gerdb/timbremin/pics/chorus_algorithm.png

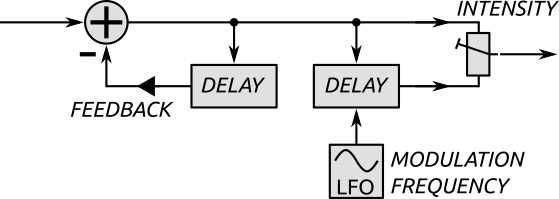
pics/chorus_algorithm.png
