gerdb/timbremin/pics/oscillators.jpg

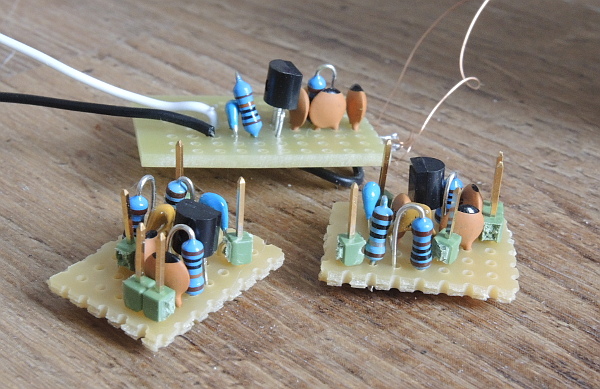
pics/oscillators.jpg
