gerdb/timbremin/pics/power_supply_photo1.jpg

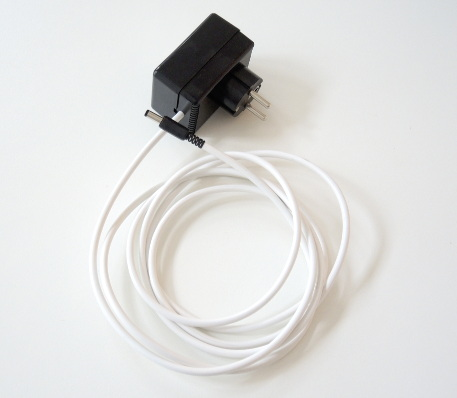
pics/power_supply_photo1.jpg
