gerdb/timbremin/pics/power_supply_photo2.jpg

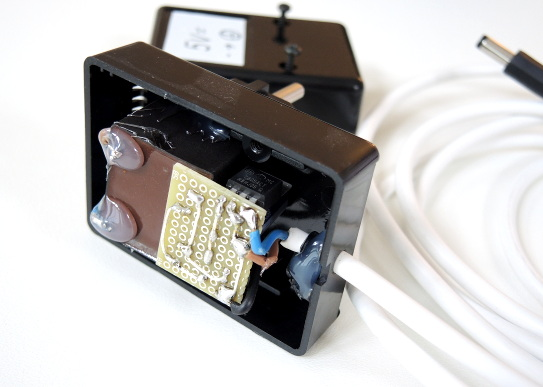
pics/power_supply_photo2.jpg
