gerdb/timbremin/pics/timbremin_osc_pcb_thd.png

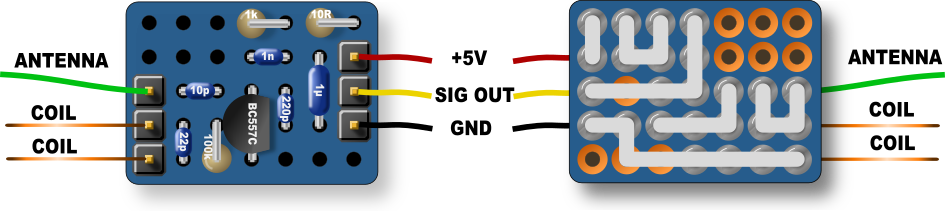
pics/timbremin_osc_pcb_thd.png
