gerdb/timbremin/Software/Src/main.c

/**
  ******************************************************************************
  * @file           : main.c
  * @brief          : Main program body
  ******************************************************************************
  * This notice applies to any and all portions of this file
  * that are not between comment pairs USER CODE BEGIN and
  * USER CODE END. Other portions of this file, whether 
  * inserted by the user or by software development tools
  * are owned by their respective copyright owners.
  *
  * Copyright (c) 2019 STMicroelectronics International N.V. 
  * All rights reserved.
  *
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
  ******************************************************************************
  */
/* Includes ------------------------------------------------------------------*/
#include "main.h"
#include "stm32f4xx_hal.h"
#include "fatfs.h"
#include "usb_host.h"

/* USER CODE BEGIN Includes */
#include "../Drivers/BSP/STM32F4-Discovery/stm32f4_discovery.h"
#include "audio_out.h"
#include "theremin.h"
#include "pots.h"
#include "config.h"
#include "beep.h"
#include "volume.h"
#include "pitch.h"
#include "effect.h"
#include "printf.h"
#include "console.h"
/* USER CODE END Includes */

ADC_HandleTypeDef hadc1;
DMA_HandleTypeDef hdma_adc1;

I2C_HandleTypeDef hi2c1;

I2S_HandleTypeDef hi2s3;

RNG_HandleTypeDef hrng;

SPI_HandleTypeDef hspi1;

TIM_HandleTypeDef htim1;

UART_HandleTypeDef huart3;

/* USER CODE BEGIN PV */


/* USER CODE END PV */

void SystemClock_Config(void);
static void MX_GPIO_Init(void);
static void MX_DMA_Init(void);
static void MX_I2C1_Init(void);
static void MX_I2S3_Init(void);
static void MX_SPI1_Init(void);
static void MX_TIM1_Init(void);
static void MX_ADC1_Init(void);
static void MX_RNG_Init(void);
static void MX_USART3_UART_Init(void);
void MX_USB_HOST_Process(void);

/* USER CODE BEGIN PFP */

/* USER CODE END PFP */

/* USER CODE BEGIN 0 */
//extern void initialise_monitor_handles(void);
int siFlag1ms = 0;

/* USER CODE END 0 */

/**
  * @brief  The application entry point.
  *
  * @retval None
  */
int main(void)
{
  /* MCU Configuration----------------------------------------------------------*/

  /* Reset of all peripherals, Initializes the Flash interface and the Systick. */
  HAL_Init();

  /* Configure the system clock */
  SystemClock_Config();

  /* Initialize all configured peripherals */
  MX_GPIO_Init();
  MX_DMA_Init();
  MX_I2C1_Init();
  MX_I2S3_Init();
  MX_SPI1_Init();
  MX_USB_HOST_Init();
  MX_TIM1_Init();
  MX_ADC1_Init();
  MX_FATFS_Init();
  MX_RNG_Init();
  MX_USART3_UART_Init();
  /* USER CODE BEGIN 2 */
  CONFIG_Init();
  POTS_Init();
  BEEP_Init();
  VOLUME_Init();
  THEREMIN_Init();
  AUDIO_OUT_Init();
  EFFECT_Init();
  CONSOLE_Init(huart3);

  HAL_TIM_Base_Start(&htim1);
  HAL_TIM_IC_Start(&htim1,TIM_CHANNEL_1);
  HAL_TIM_IC_Start(&htim1,TIM_CHANNEL_2);
  HAL_TIM_IC_Start(&htim1,TIM_CHANNEL_3);

  BSP_PB_Init(BUTTON_KEY, BUTTON_MODE_GPIO);
  /* USER CODE END 2 */

  /* Infinite loop */
  /* USER CODE BEGIN WHILE */
  while (1)
  {
  /* USER CODE END WHILE */
    MX_USB_HOST_Process();

  /* USER CODE BEGIN 3 */
	if (siFlag1ms)
	{
		siFlag1ms = 0;
	    THEREMIN_1msTask();
	    VOLUME_1msTask();
	    PITCH_1msTask();
	    POTS_1msTask();
	    AUDIO_OUT_1msTask();
	    CONSOLE_1msTask();
	    EFFECT_1msTask();
	}
  }
  /* USER CODE END 3 */

}

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
