gerdb/timbremin/Software/Inc/beepwave.h

/**
 *  Project     timbremin
 *  @file		notes.h
 *  @author		Gerd Bartelt - www.sebulli.com
 *  @brief		Wave table with beep sound
 *
 *  @copyright	GPL3
 *
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
 */

#ifndef BEEPWAVE_H_
#define BEEPWAVE_H_

const int16_t usBeepWave[1024] = {0	,
		201	,
		402	,
		603	,
		804	,
		1005	,
		1206	,
		1407	,
		1608	,
		1809	,
		2009	,
		2210	,
		2410	,
		2611	,
		2811	,
		3012	,
		3212	,
		3412	,
		3612	,
		3811	,
		4011	,
		4210	,
		4410	,
		4609	,
		4808	,
		5007	,
		5205	,
		5404	,
		5602	,
		5800	,
		5998	,
		6195	,
		6393	,
		6590	,
		6786	,
		6983	,
		7179	,
		7375	,
		7571	,
		7767	,
		7962	,
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

};

#endif /* BEEPWAVE_H_ */
