gerdb/timbremin/Software/Src/printf.c

/*
 *  Project:      timbremin
 *  File:         printf.c
 *  Author:       Gerd Bartelt - www.sebulli.com
 *
 *  Description:  This a an modified version of printf
 *  			  Original file is written by Georges Menie.
 *
 */

/*
	Copyright 2001, 2002 Georges Menie (www.menie.org)

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
    You should have received a copy of the GNU Lesser General Public License
    along with this program; if not, write to the Free Software
    Foundation, Inc., 59 Temple Place, Suite 330, Boston, MA  02111-1307  USA
*/

/*
	putchar is the only external dependency for this file,
	if you have a working putchar, just remove the following
	define. If the function should be called something else,
	replace outbyte(c) by your own function call.
*/

/* Includes ------------------------------------------------------------------*/
#include "printf.h"

/**
 * The printchar function that uses the USART
 */
static void printchar(int c)
{
	CONSOLE_PutByte(& UartHandle, c);
}

#define PAD_RIGHT 1
#define PAD_ZERO 2

static int prints(const char *string, int width, int pad)
{
	register int pc = 0, padchar = ' ';

	if (width > 0) {
		register int len = 0;
		register const char *ptr;
		for (ptr = string; *ptr; ++ptr) ++len;
		if (len >= width) width = 0;
		else width -= len;
		if (pad & PAD_ZERO) padchar = '0';
	}
	if (!(pad & PAD_RIGHT)) {
		for ( ; width > 0; --width) {
			printchar (padchar);
			++pc;
		}
	}
	for ( ; *string ; ++string) {
		printchar (*string);
		++pc;
	}
	for ( ; width > 0; --width) {
		printchar (padchar);
		++pc;
	}

	return pc;
}

/* the following should be enough for 32 bit int */
#define PRINT_BUF_LEN 12

static int printi(int i, int b, int sg, int width, int pad, int letbase)
{
	char print_buf[PRINT_BUF_LEN];
	register char *s;
	register int t, neg = 0, pc = 0;
	register unsigned int u = i;

	if (i == 0) {
		print_buf[0] = '0';
		print_buf[1] = '\0';
		return prints (print_buf, width, pad);
	}

	if (sg && b == 10 && i < 0) {
		neg = 1;
		u = -i;
	}

	s = print_buf + PRINT_BUF_LEN-1;
	*s = '\0';

	while (u) {
		t = u % b;
		if( t >= 10 )
			t += letbase - '0' - 10;
		*--s = t + '0';
		u /= b;
	}

	if (neg) {
		if( width && (pad & PAD_ZERO) ) {
			printchar ('-');
			++pc;
			--width;
		}
		else {
			*--s = '-';
		}
	}

	return pc + prints (s, width, pad);
}

static int print(int *varg)
{
	register int width, pad;
	register int pc = 0;
	register char *format = (char *)(*varg++);
	char scr[2];

	for (; *format != 0; ++format) {
		if (*format == '%') {
			++format;
			width = pad = 0;
			if (*format == '\0') break;
			if (*format == '%') goto out;
			if (*format == '-') {
				++format;
				pad = PAD_RIGHT;
			}
			while (*format == '0') {
				++format;
				pad |= PAD_ZERO;
			}
			for ( ; *format >= '0' && *format <= '9'; ++format) {
				width *= 10;
				width += *format - '0';
			}
			if( *format == 's' ) {
				register char *s = *((char **)varg++);
				pc += prints ( s?s:"(null)", width, pad);
				continue;
			}
			if( *format == 'd' ) {
				pc += printi ( *varg++, 10, 1, width, pad, 'a');
				continue;
			}
			if( *format == 'x' ) {
				pc += printi ( *varg++, 16, 0, width, pad, 'a');
				continue;
			}
			if( *format == 'X' ) {
				pc += printi ( *varg++, 16, 0, width, pad, 'A');
				continue;
			}
			if( *format == 'u' ) {
				pc += printi ( *varg++, 10, 0, width, pad, 'a');
				continue;
			}
			if( *format == 'c' ) {
				/* char are converted to int then pushed on the stack */
				scr[0] = *varg++;
				scr[1] = '\0';
				pc += prints (scr, width, pad);
				continue;
			}
		}
		else {
		out:
			printchar (*format);
			++pc;
		}
	}
	return pc;
}

/* assuming sizeof(void *) == sizeof(int) */

int my_printf(const char *format, ...)
{
	register int *varg = (int *)(&format);
	return print(varg);
}
