gerdb/timbremin/Software/Inc/notes.h

/**
 *  Project     timbremin
 *  @file		notes.h
 *  @author		Gerd Bartelt - www.sebulli.com
 *  @brief		Frequency of piano notes
 *
 *  @copyright	GPL3
 *
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
 */

#ifndef NOTES_H_
#define NOTES_H_

#define	NOTE_C8		4186.01f
#define	NOTE_B7		3951.07f
#define	NOTE_AIS7	3729.31f
#define	NOTE_A7		3520.00f
#define	NOTE_GIS7	3322.44f
#define	NOTE_G7		3135.96f
#define	NOTE_FIS7	2959.96f
#define	NOTE_F7		2793.83f
#define	NOTE_E7		2637.02f
#define	NOTE_DIS7	2489.02f
#define	NOTE_D7		2349.32f
#define	NOTE_CIS7	2217.46f
#define	NOTE_C7		2093.00f
#define	NOTE_B6		1975.53f
#define	NOTE_AIS6	1864.66f
#define	NOTE_A6		1760.00f
#define	NOTE_GIS6	1661.22f
#define	NOTE_G6		1567.98f
#define	NOTE_FIS6	1479.98f
#define	NOTE_F6		1396.91f
#define	NOTE_E6		1318.51f
#define	NOTE_DIS6	1244.51f
#define	NOTE_D6		1174.66f
#define	NOTE_CIS6	1108.73f
#define	NOTE_C6		1046.50f
#define	NOTE_B5		987.77f
#define	NOTE_AIS5	932.33f
#define	NOTE_A5		880.00f
#define	NOTE_GIS5	830.61f
#define	NOTE_G5		783.99f
#define	NOTE_FIS5	739.99f
#define	NOTE_F5		698.46f
#define	NOTE_E5		659.26f
#define	NOTE_DIS5	622.25f
#define	NOTE_D5		587.33f
#define	NOTE_CIS5	554.37f
#define	NOTE_C5		523.25f
#define	NOTE_B4		493.88f
#define	NOTE_AIS4	466.16f
#define	NOTE_A4		440.00f
#define	NOTE_GIS4	415.31f
#define	NOTE_G4		392.00f
#define	NOTE_FIS4	369.99f
#define	NOTE_F4		349.23f
#define	NOTE_E4		329.63f
#define	NOTE_DIS4	311.13f
#define	NOTE_D4		293.67f
#define	NOTE_CIS4	277.18f
#define	NOTE_C4		261.63f
#define	NOTE_B3		246.94f
#define	NOTE_AIS3	233.08f
#define	NOTE_A3		220.00f
#define	NOTE_GIS3	207.65f
#define	NOTE_G3		196.00f
#define	NOTE_FIS3	185.00f
#define	NOTE_F3		174.61f
#define	NOTE_E3		164.81f
#define	NOTE_DIS3	155.56f
#define	NOTE_D3		146.83f
#define	NOTE_CIS3	138.59f
#define	NOTE_C3		130.81f
#define	NOTE_B2		123.47f
#define	NOTE_AIS2	116.54f
#define	NOTE_A2		110.00f
#define	NOTE_GIS2	103.83f
#define	NOTE_G2		98.00f
#define	NOTE_FIS2	92.50f
#define	NOTE_F2		87.31f
#define	NOTE_E2		82.41f
#define	NOTE_DIS2	77.78f
#define	NOTE_D2		73.42f
#define	NOTE_CIS2	69.30f
#define	NOTE_C2		65.41f
#define	NOTE_B1		61.74f
#define	NOTE_AIS1	58.27f
#define	NOTE_A1		55.00f
#define	NOTE_GIS1	51.91f
#define	NOTE_G1		49.00f
#define	NOTE_FIS1	46.25f
#define	NOTE_F1		43.65f
#define	NOTE_E1		41.20f
#define	NOTE_DIS1	38.89f
#define	NOTE_D1		36.71f
#define	NOTE_CIS1	34.65f
#define	NOTE_C1		32.70f
#define	NOTE_B0		30.87f
#define	NOTE_AIS0	29.14f
#define	NOTE_A0		27.50f

#endif /* NOTES_H_ */
