gerdb/timbremin/(commit log)

2018-11-16 First import of software
    [timbremin Debug Semihosting.cfg, timbremin Debug.cfg, timbremin Semihosting.cfg]
2018-12-16 Write volume calibration result to USB stick. Beeps only on headphone output
2018-12-25 PITCH calibration
2018-12-26 Use of pitch table to scale and shift the pitch values
2018-12-28 Scaled frequency to Hz for pitch display Index of config file in round brackets
2018-12-28 Removed WAV table support. Added non-linearity of sin oscillator. Bugfix amplitude regulation of oscillator.
    [audio_out.c, audio_out.h, beep.c, theremin.c, theremin.h]
2018-12-29 Start with auto-tune after start-up not earlier than after the power-on beep. Reduced volume of beep.
2019-01-10 Updated Logo and added power supply pictures
2019-01-10 Updated PCB of oscillator
2019-01-11 Updated BOM
2019-01-26 Pitch filter is running during "beep" to ensure proper values during auto-tune. Output values clipped.
2019-02-03 Added 2 photos of the power suplly unit
2019-02-16 Debug output of HF-oscillator values Renames some function names
    [audio_out.c, config.c, console.c, console.h, effect.c, effect.h, main.c, theremin.c]
2019-02-16 Bugfix: Characters were lost during sending a string.
    [console.c]
2019-02-16 Extended Range of oscillators. Stopwatch in console
    [audio_out.c, console.c, console.h, theremin.c, theremin.h]
2019-02-16 Increase fundamental by state variable filter instead of adding a sine. Fix: Use 1.0f instead of 1.0 (double)
    [audio_out.c, theremin.c]
2019-02-16 Mix sine, rectangle and sawtooth. Lowpass filter oscillator
    [theremin.c]
2019-02-17 Console: read of all parameters Chorus: longer delay 2nd LowPass after audio oscillator
    [config.c, config.h, effect.c, theremin.c]
2019-02-17 Added 30Hz HighPass filter
2019-02-17 Use direct sine oscillator if sine part is more than 99% 3rd order LP filter after audio oascillator
    [theremin.c]
2019-02-18 Added filter for 2nd harmonics
2019-02-20 Added 2 pages "firmware" and "housing"
2019-02-20 New page: Sound samples
2019-02-21 Extended pitch oscillator range from 100kHz .. 1000kHz
    [theremin.c, theremin.h]
2019-02-24 Pitch oscillator from 100kHz .. 1MHz continuously
    [console.c, console.h, theremin.c, theremin.h]
2019-02-25 Organized global variables by using oscillator data structures
    [console.c, pitch.c, theremin.c, theremin.h, volume.c]
2019-03-02 Extra antenna for timbre
2019-03-08 Changed filters and audio oscillators
    Expand Pot values to 0% and 100%
    [config.c, config.h, pots.c, pots.h, theremin.c]
2019-03-31 Bugfix Chorus, LowPass Filter
    [effect.c, effect.h, theremin.c]
